armluk/arm-gps-tempo-test/README.md

# GPS-Tempo-Test

Testseite Arm Eggiwil AG (Güllefass-Rechner): zeigt die GPS-Geschwindigkeit des Handys und einen Pfeil, wenn die Soll-Geschwindigkeit um mehr als 0.5 km/h abweicht.
