armluk/arm-gps-tempo-test/arm-signet.png

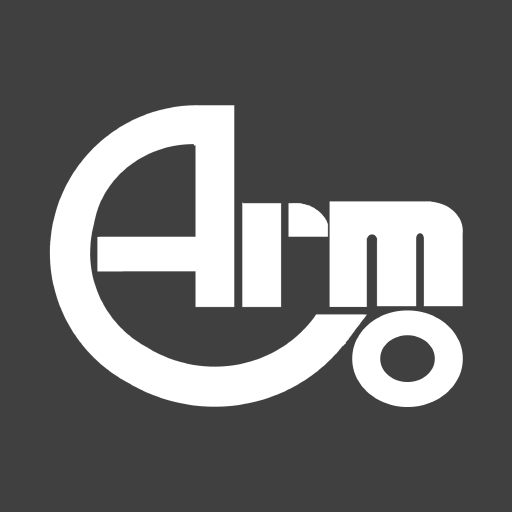
arm-signet.png
