armluk/arm-gps-tempo-test/esp32/distrelec-stueckliste.csv

Artikelnummer | Menge | Referenz
303-83-819 | 1 | U3 XIAO nRF52840
169-53-484 | 1 | U2 TSR 1-2450
175-20-642 | 1 | U1 CNY17-3
304-42-973 | 1 | D1 D4 1N5819 (Packung 100)
304-45-455 | 1 | D2 SMBJ33A (Packung 25)
170-12-019 | 25 | D3 BAT41 (Mindestmenge 25)
304-42-380 | 1 | F1 MF-R050 (Packung 10)
304-43-123 | 1 | R1 3.3k 0.6W (Packung 50)
304-98-687 | 1 | R2 1k 2W (Packung 10)
167-25-806 | 50 | C1 10uF 50V (Mindestmenge 50)
304-42-838 | 1 | C2 22uF 25V
305-08-226 | 1 | Schrumpfschlauch 24/8 1.2 m
143-83-921 | 1 | Stiftleiste 1x36 2.54 mm (XIAO, 2x7 abbrechen)
304-65-922 | 1 | Lochrasterplatine 100x160 mm 2.54 mm
