armluk/arm-gps-tempo-test/(commit log)

2026-10-13 Stillstand: Strich bei Geschwindigkeit, = anstelle der Pfeile
2026-10-13 Neue Ansicht Karte: Aufzeichnung der ueberfahrenen Flaeche (Start/Stopp, Arbeitsbreite, Balkenabstand, KML/GeoJSON)
2026-10-13 Karte: Positionsquelle Antenne mit Abstand und seitlichem Versatz, RTK-Anzeige in cm, keine Glaettung bei RTK
2026-10-13 Durchflussmesser (ESP32, Bluetooth LE): Ist-Durchfluss, Ist-Menge, gemessene m3, Karte nach Menge eingefaerbt; ESP32-Software und Anschlussplan
2026-10-13 Entwurf Traegerplatine fuer M5Stack ATOM Lite (12 V, Optokoppler, Grove)
2026-10-13 Platine V2: Litzen VIN 8-30 V / GND / SIG mit 1 kOhm, TRACO TSR 1-2450, Netzliste und Stueckliste
2026-10-13 Platinenschema V3: Pulldown 1 kOhm am Sensor (D nach GND), Platine greift hochohmig ab
2026-10-13 Platinenschema V4: Pulldown 1 kOhm / 2 W auf der Platine (R2)
2026-10-13 Platine V5: Seeed XIAO ESP32-C3 aufgeloetet (Impuls an D10, 5V ueber Schottky), Software angepasst
2026-10-13 Stueckliste Durchfluss-Sender Variante 2 (Modul ausserhalb Sensorgehaeuse)
2026-10-13 Distrelec-Bestelldatei (CSV) und Preise aus Warenkorb-Test
    [distrelec-stueckliste.csv]
2026-10-13 Bestellliste: Stiftleiste 1x36 und Lochrasterplatine ergaenzt
    [DistrelecImport-Guelle-Durchfluss.xls, distrelec-stueckliste.csv]
2026-10-13 Bestueckungsplan-PDF: Seite 1 massstabsgetreu 1:1 und 2:1 mit 50-mm-Kontrollbalken
2026-10-14 Karte: Parzellennummer (geo.admin CadastralWebMap) unten in der Karte anzeigen
2026-10-14 Export: befahrene Parzellen mit Fläche in GeoJSON und KML
2026-10-14 Karte: Parzellen- und Tempo-Feld kleiner, Pfeil nur neben dem Traktor
2026-10-14 Eine App: Tempo und Karte als Ansichten einer Seite, Menü für beide, Karte als Standard
2026-10-14 Karte: Sonar-Ring statt Pfeil (innen = zu schnell, aussen = zu langsam), Punkt grau bei Wenden/Stillstand, hohl ohne GPS
2026-10-14 Karte: Detail-Taste – feste Zoomstufe, Verteiler füllt 50 % der Kartenbreite
2026-10-14 Karte: Bildrate nach Ladezustand (60/30 Bilder/s), Pause bei Stillstand, Tempo-Ansicht und offenem Menü
2026-10-14 Betriebssicherheit: Zwischenspeichern + Fortsetzen, Ausbringen ein/aus, Stopp halten
    - Aufzeichnung alle 30 s und beim Wechsel in den Hintergrund speichern, nach Absturz fortsetzen
    - Fortsetzen auch nach dem Stoppen; Spur in Abschnitten, Dauer ohne Pause
    - Taste «Ausbringen ein/aus» (ohne Durchflussmesser) für Fahrten zur Grube
    - Stoppen nur mit 1 s gedrückt halten
    - Durchfluss als Zunahmen summieren (Neustart des Moduls verfälscht die Menge nicht)
    - GPS-Meldung verschwindet wieder und schliesst das Menü nicht
    - Dateiname in Ortszeit; Demo im Bereich «Test», ersetzt keine echte Karte
2026-10-14 Liste der Aufzeichnungen (ein Fass = eine Aufzeichnung, IndexedDB) und Querformat-Layout
2026-10-15 Karte: 200-m-Taste und Lupe funktionieren auch ohne GPS; Lupe nochmals = zurück auf 200 m
2026-10-15 Durchfluss: unter 5 m3/h kein Durchfluss; Ausblasen (starke Schwankung) erkennen – Modul sendet Schwankung
2026-10-15 Mit Durchflussmesser: erstes Feld zeigt Durchfluss statt Tempo (Tempo steht auf der Karte)
2026-10-15 Durchfluss-Korrektur ±15 % (Dichte der Gülle)
2026-10-18 Sensor heisst SpreadLink-<Nummer aus Chip-ID>; App merkt sich den Sensor und verbindet direkt
2026-10-20 SpreadLink: Sensor-Update per Bluetooth (nur nach Anmeldung)
2026-10-31 Pumpen-Volumenstrom (20-250 m3/h) statt Soll-Geschwindigkeit: Soll-Tempo, Ist-Menge und Gülle ohne Durchflussmesser berechnet
2026-10-31 Bericht: Kunde erfassen, PDF erstellen und teilen (WhatsApp, E-Mail) oder speichern
2026-10-31 Slogan «Güllentechnik auf höchstem Level» in App-Kopf und PDF
2026-11-10 Durchfluss-Korrektur: Rohwerte speichern, offene Aufzeichnung wird bei Änderung ganz neu gerechnet, abgeschlossene bleiben fest
